dorna-robotics/blog/drawing/readme.md

# Tracing an Image

<p align="center">
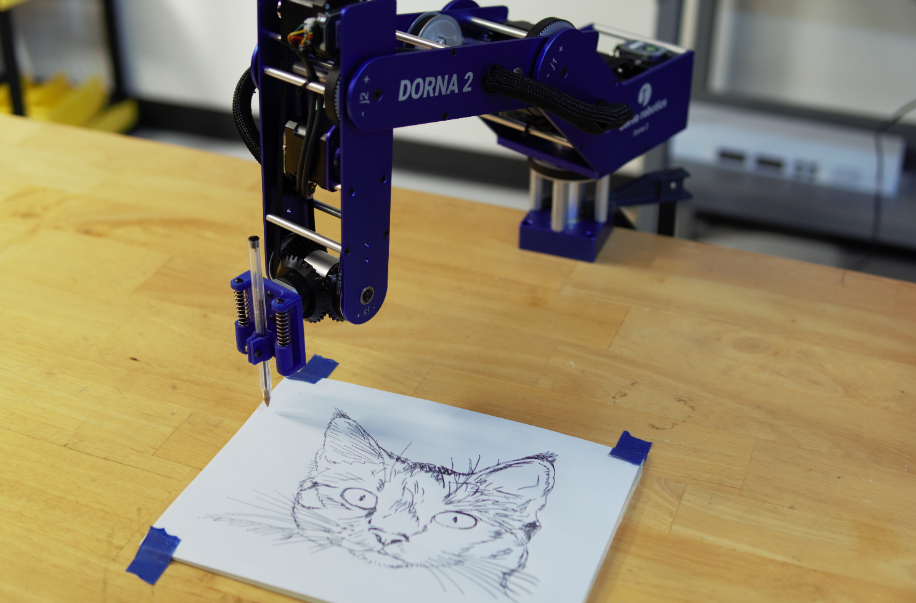
[picture p1: drawing/pictures/Thumbnail.png]

</p>

<p align="center">
<a href="https://youtu.be/N5IlFthJBqI">Link to Youtube video</a>
</p>

In this video we will go over the setup and the capabilities of the Dorna 2 robot for drawing an image. Dorna 2 robot can replicate SVG file to draw an image on a given surface. In this experiment we use Python programming language for converting the SVG file into robot commands.
 
You can find the original document here on our website:
https://dorna.ai/blog/dorna-drawing/
## Toolhead Installation
### Parts
We will need to attach the pen holder toolhead. We have the links to the materials below. You can use a 3D printer for two of the parts and you will need to order a few of the materials. 
|Items|Links|
|---|----|
|Two 3D printed parts|[link](https://github.com/dorna-robotics/dorna2_otto/tree/main/drawing/STL%20files)|
|9 x M3 10mm length and 1 x M3 bolt|[link](https://www.amazon.com/Sutemribor-320Pcs-Stainless-Button-Assortment/dp/B07CYNKLT2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)|
|2 x 35mm springs|[link](https://www.amazon.com/1mmx12mmx35mm-Stainless-Compression-Springs-Connector/dp/B08N6TKX5G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)|
|1 x pen(preferably a Bic pen)|[link](https://www.amazon.com/BIC-Round-Ballpoint-Medium-36-Count/dp/B00347A8NK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)|
|2 x 50mm Standoff Column Spacers with 5mm outer diameter|[link](https://www.amazon.com/uxcell-Aluminum-Standoff-Airplane-Quadcopter/dp/B07MJBHKDP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)|

<p align="center">
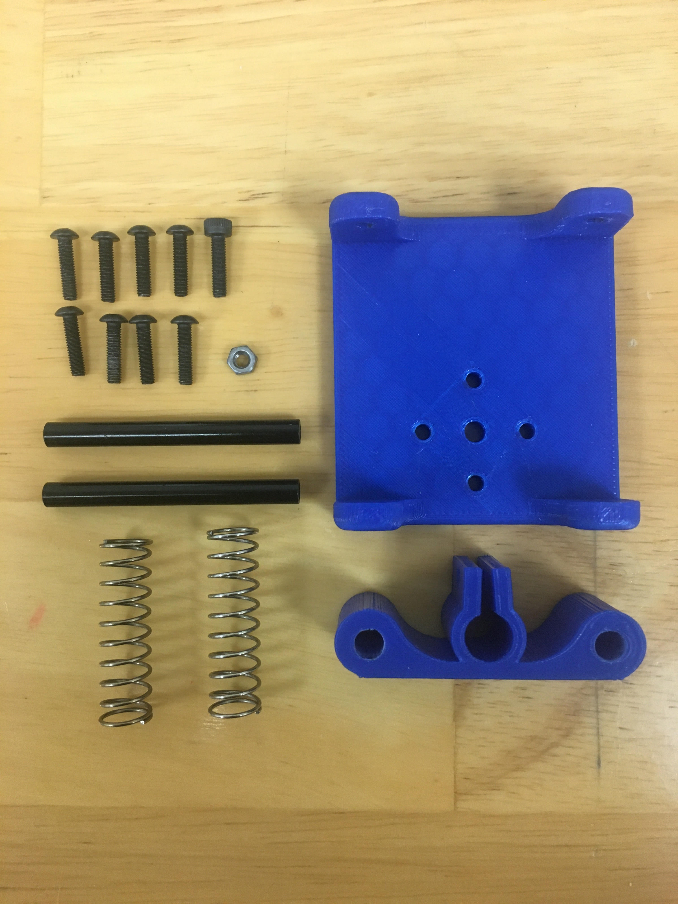
[picture p2: drawing/pictures/materiallist.jpg]

</p>

### Construction
Put the smaller 3D printed piece around the shafts and the springs attached as well. If the shaft doesn't slide along the small 3D printed piece it is recommended to sand paper the holes down. Make sure to have the small 3D printed piece oriented to hug the wall farthest from the mount holes on the larger 3D printed piece as shown below. Screw four M3 screws into the ends of the shafts to lock them in. Now attach the part to the Dorna 2 robot by using four M3 screws. Lastly put the pen through the large hole and screw on an M3 bolt and nut. If the pen is too small for the hole, an easy solution can be to wrap it in tape to create a bigger outer diameter for the pen.

<p align="center">
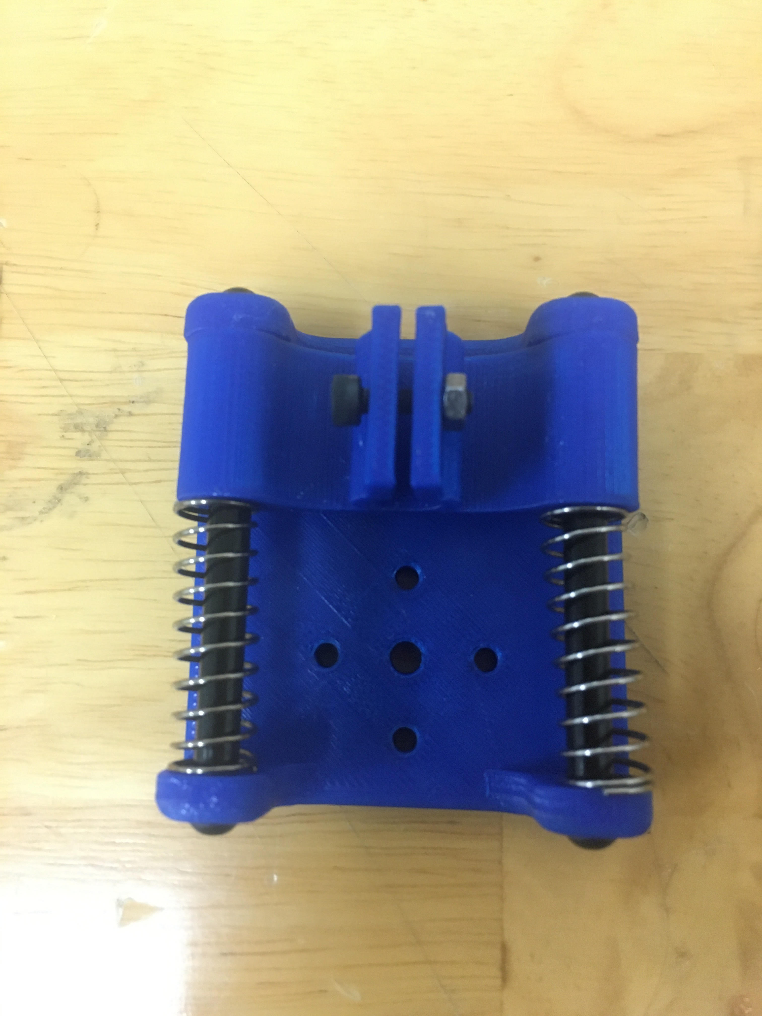
[picture p3: drawing/pictures/Topview.jpg]

</p>

## Code
A link to the code: https://github.com/dorna-robotics/blog/tree/main/drawing/code
### Image
Find an image in SVG format or convert a file to SVG format (use [InKscape](https://inkscape.org/) for that purpose). You can read into how the SVG format works thanks to [MDN](https://developer.mozilla.org/en-US/docs/Web/SVG/Tutorial/Paths).
### Actions Needed to Run
Here we use Python for programming the robot. You need to download [Python](https://www.python.org/downloads/) and [Dorna 2 Python API](https://doc.dorna.ai/docs/api/python/manual/) if you haven't already done so. The line below allows you to connect to your Dorna 2. Replace the `"robot_ip_address"` based on your robot ip address, [for more information on the API](https://doc.dorna.ai/docs/api/python/manual/).
```python
robot.connect("robot_ip_address", 443)
```
The line below takes the path to the SVG file and generates the commands associated to that SVG file.
```python
cmds, cmds_length = svg(10).gen('filename.svg', width, length, 0, 0, a, b, cp, scale, velocity, acceleration, jerk, corner)
```
When the program is run. It will ask you to turn off the motors. Be sure to hold the robot when turning off the motors because it will fall. Then a command will ask you to direct your robot to the left bottom corner of your paper. Make sure to have the toolhead attachment perpendicular to the surface. Not doing so will have the tool attachment going deeper into the surface than desired when drawing the image. For each point, set the pen so it is barely touching the surface. The command will then ask you to direct the robot to the top right of the paper. Lastly you will then direct the robot to a point along the line clockwise of the left bottom coordinate as shown below. A command asking to turn on the motors will come up. After doing so, the Dorna 2 robot will draw the image.

<p align="center">
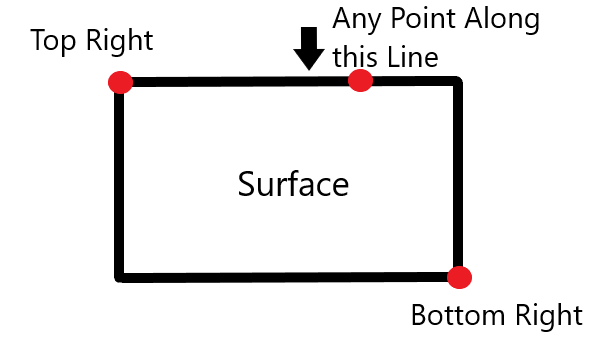
[picture p4: drawing/pictures/Setup.png]

</p>

This part of the code allows you to change the parameters for a faster drawing or a more precise drawing. Recommendations are given, but the numbers can be changed. The numbers will change the upper limits of the motion parameters.
```python
#the drawing will become slower and more precise by decreasing the numbers below
#the drawing will be drawn faster but less precise by increasing the numbers below
#changing the numbers will change the upper limits of the robots motion parameters
#recommended velocity = 50
velocity = 50
#recommended acceleration = 300
acceleration = 300
#recommended jerk = 3000
jerk = 3000
#recommended corner = 5
corner = 5
```
## Explanation of Code
### Main Function
We can take a look at the main function. This section is at the bottom of the code. The main function starts by connecting to the robot.
```python
if __name__ == '__main__':
    robot = dorna()
    print("connecting")
    robot.connect("ip address", 443)
    wait_id = 100
    print("done connecting")
    
```

Next the starting points are initialized by calling the `.startingpoints()` function. With the guidance of the user we can set the 3 points of the paper to understand the size of the paper and to understand the equation of the plane. This is used so if the surface isn't completely flat the program will modify the path to a new plane.

```python
#intialize the 3 points on the plane,Left Bottom-Point along line-Top Right
error, LB, M, TR = startingpoints(robot)
#check if there is an error from last function called
if(error == 1):
    print("need to restart")
    robot.close()
```
Next we call a function that allows us to find a 3rd corner of the paper. This helps us define the papers width and length and allows the program to have a upper limit for the surfaces width and length in 3D space.
```python
#calls function to find 3rd corner for new plane
TL = findcorner(LB, M, TR)
```
Now, we want to convert all points on an xy plane of the input SVG file to a xyz plane of the robot. This can be done by a linear formula of

[[x],[y],[z]]= T * [[x0],[y0]] + B

The T stands for transformation and can be solved using the 3 corners of the plane. T is a 3x2 matrix. B is a 3x1 matrix. B is the starting position's coordinates. 
Next we want to find the perpendicular vector from the plane. This will help to move the robot away from the paper when lifting the pen on a drawing.
```python
#perpendicular vector in unit vector form
cp = perpendicularvector(LB, M, TR)
```
Next is a function that creates the path. This is the bulk of the code. This function creates a xy path from the SVG path provided. The function will then transform the 2D path into a 3D path. The 3D path will then be translated into robot commands. 
```python
cmds, cmds_length = svg(10).gen(‘filename.svg', width, length, 0, 0, a, b, cp, scale, velocity, acceleration, jerk, corner)
```
The last few lines of the code takes the list of commands created from the the function above and sends it to the robot to perform. The robot will close the WebSocket connection and stop moving when the image is done. [For more information on robot commands](https://doc.dorna.ai/docs/cmd/intro/).
```python
 command_list=[]
 i=0
 stop=True
 while stop:
     for cmd in cmds:
         for c in cmd:
             command_list.append(robot.play(True, **c))
             if len(command_list)==cmds_length[i]:
                 last_continous_point = command_list.pop()
                 status = last_continous_point.complete()
                 command_list=[]
                 if(status == 2):
                     pass
                 else:
                     arg = {"cmd": "halt", "id":1000}
                     robot.play(True, **arg)
                     break
         i+=1
         if len(cmds_length)== i:
             stop=False
 print("done")
 robot.close()
```
