dorna-robotics/blog/camera/readme.md

# Additional Axes using a Camera Motor and Rail

<p align="center">
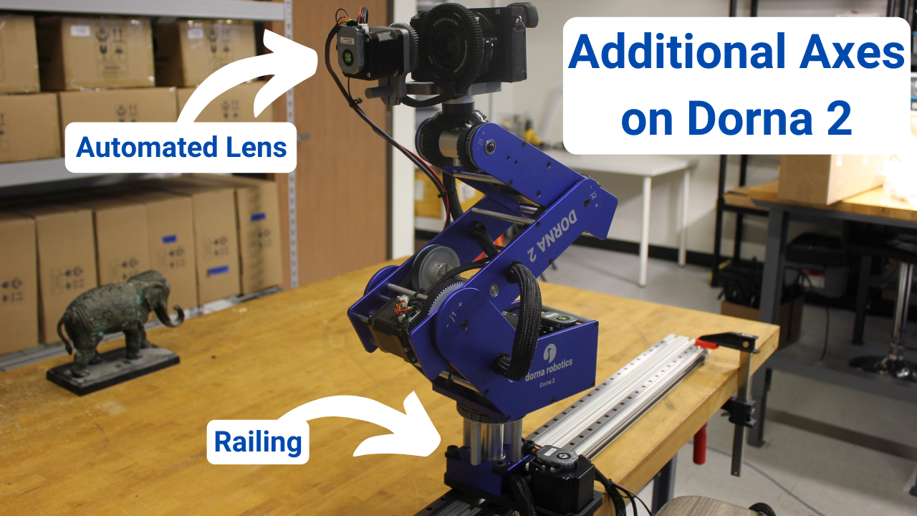
[picture p5: camera/pictures/thumbnail.png]

</p>

<p align="center">
<a href="https://www.youtube.com/watch?v=5VFXYQXdnUo">Link to Youtube video</a>
</p>
In this document we will showcase the Dorna 2's ability to add multiple degrees of freedom. We will go over the construction and the application of the camera attachment and railing.

## Camera Attachment

### Construction

Down below are all the materials you will need to run your Dorna 2 Robot with a camera attachment.

#### Building the Mount

|Items|Links|
|---|----|
|Three 3D printed parts| [link](https://github.com/dorna-robotics/blog/tree/main/camera/STL%20files) |
|8 x M3 bolts 8mm length, 2 x M3 Hex Nuts, 2 x M3 bolts 20mm length|[link](https://www.amazon.com/Sutemribor-320Pcs-Stainless-Button-Assortment/dp/B07CYNKLT2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)|
|1 x 1/4" bolt 3/8" length|[link](https://www.amazon.com/Socket-Stainless-Machine-Threads-RoyceMart/dp/B084NWFJZB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)|
|1 x Gear Strip|[link](https://www.amazon.com/Rubber-Flexible-DP500IIS-DP500III-Adjustable/dp/B078QYL2M8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)|
|1 x Driver and 1 x Stepper Motor and Wires||

<p align="center">
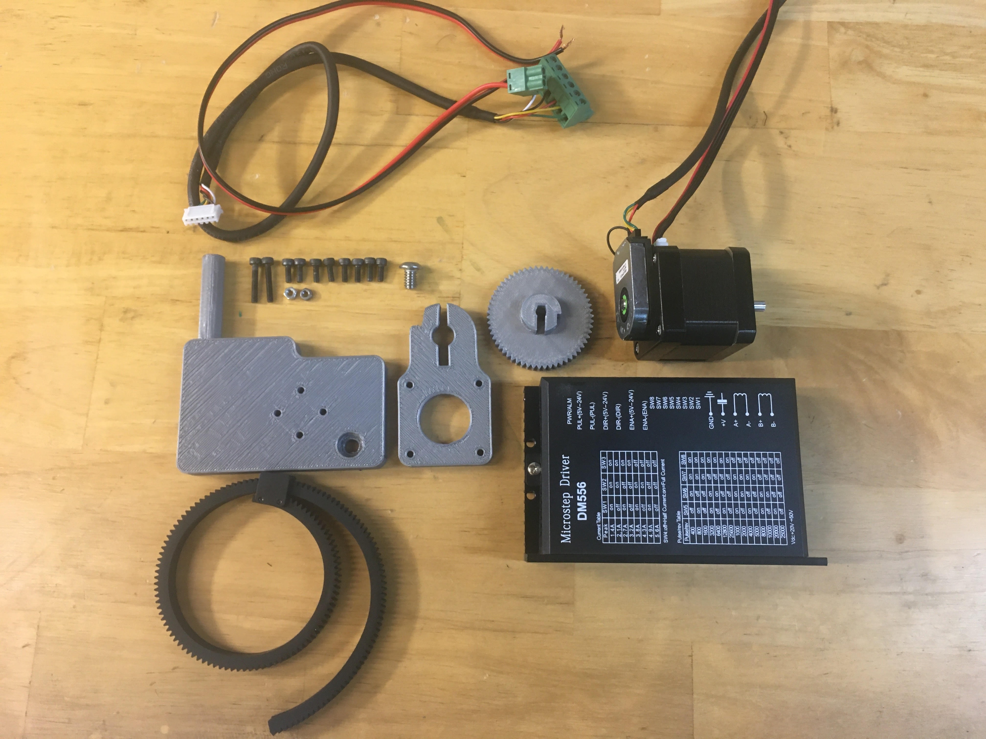
[picture p6: camera/pictures/construction.jpg]

</p>

Start by connecting the stepper motor to the motor-attachment(3D-printed part) by screwing the 4 x M3 bolts 8mm length into the four holes. Connect the gear(3D printed part) to the shaft of the stepper motor and tighten the gear to stop any slipping by screwing the M3 bolt 20mm length with a M3 hex nut. Home the robot before attaching the mount(3D printed part) to the robot. Then attach the mount to the robot with 4 x M3 bolts 8mm length. Attach the camera through the biggest hole on the camera mount using the 1/4" bolt 3/8" length. Orientate the camera so the lens is parallel to the shaft sticking out of the mount and facing towards that direction. Now attach the gearstrip to the camera lens so that the clip of the gearstrip is farthest from the shaft sticking out of the mount. Attach the motor attachment and mesh the gear to the gear strip. Tighten it with a M3 bolt 20mm length and M3 hex nut.

<p align="center">
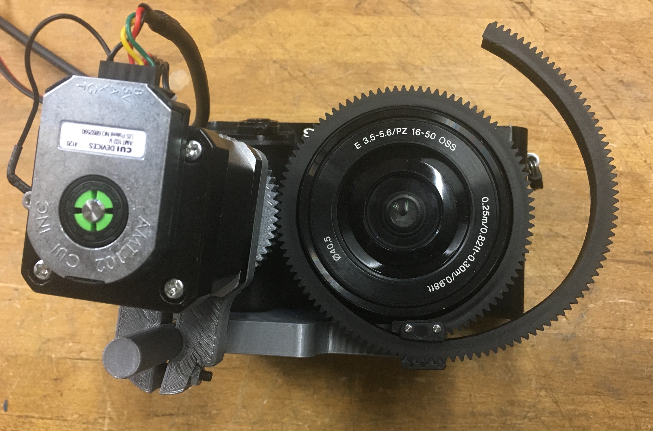
[picture p7: camera/pictures/cameramount.jpg]

</p>

#### Connecting to the Robot

Attach stepper motor to the stepper motor driver. Connect the encoder and stepper motor driver to the control box for the Dorna 2. The picture below shows inside the control box. The picture has a blue box showing the wiring for the encoder. The picture has a red box showing the wiring for the stepper motor driver. Currently a stepper motor is in the 6 axes position. An encoder would be plugged in directly across from stepper motor driver associated to it. Wire the enable, pulse, and direction into the driver. Be sure to choose the right wires. This can be easily obtained by putting the white plastic attachement into the control box and reading what color wire associates to what parameter(Enable, Pulse, and Direction). 

<p align="center">

</p>

### Application

Go to [lab.dorna.ai](http://lab.dorna.ai) and connect the robot and home it. Go to settings and then go to parameters and choose the correct number of axes. For each additional axes added be sure to count up from 5. In this case specifically choose 6 because we have 1 additional axes. Now you can input for j5 and find the values for the maximum and minimum extremes of j. Camera lens turn to different set angles so it is important to find the extremes. Set one side to 0 and spin the lens to find the maximum degree for j. Now you are able to teach your Dorna 2 to film using [lab.dorna.ai](https://lab.dorna.ai) or Python.

To learn more about the [Python API](https://doc.dorna.ai/docs/api/python/manual/) for those that want to use Python to control the Dorna 2. The additional axes can also be controlled in Python.
## Railing

### Construction

[Buy a Dorna Rail](https://dorna.ai/product/dorna-rail/)

[For the documentation on how to set up your Dorna rail](http://doc.dorna.ai/docs/accs/rail/)

### Application

Add one additional axes in [lab.dorna.ai](http://lab.dorna.ai) settings. For this specific case we now have 7 axes. Now you can operate both the railing and camera.
