dorna-robotics/blog/camera/STL files/gear.STL

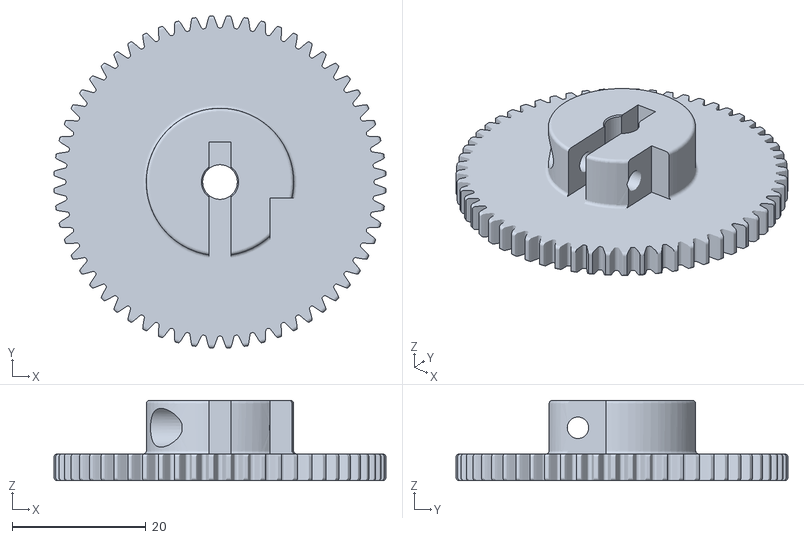
[picture p8: CAD file, 2021-07-02]
camera/STL files/gear.STL
49.6 x 49.6 x 12.0
