dorna-robotics/blog/drawing/STL files/PenHolderBase.STL

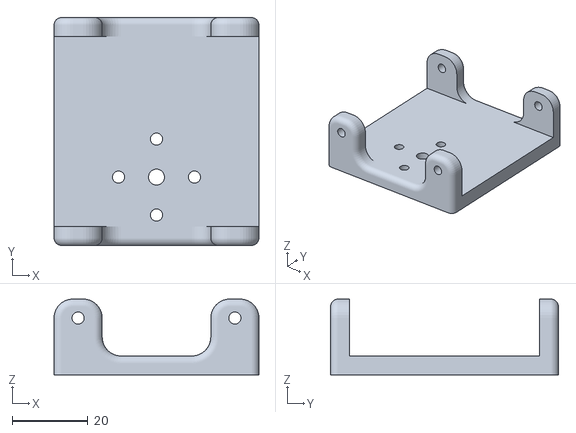
[picture p9: CAD file, 2021-06-16]
drawing/STL files/PenHolderBase.STL
54.0 x 60.0 x 20.0
