dorna-robotics/blog/camera/STL files/Mount.STL

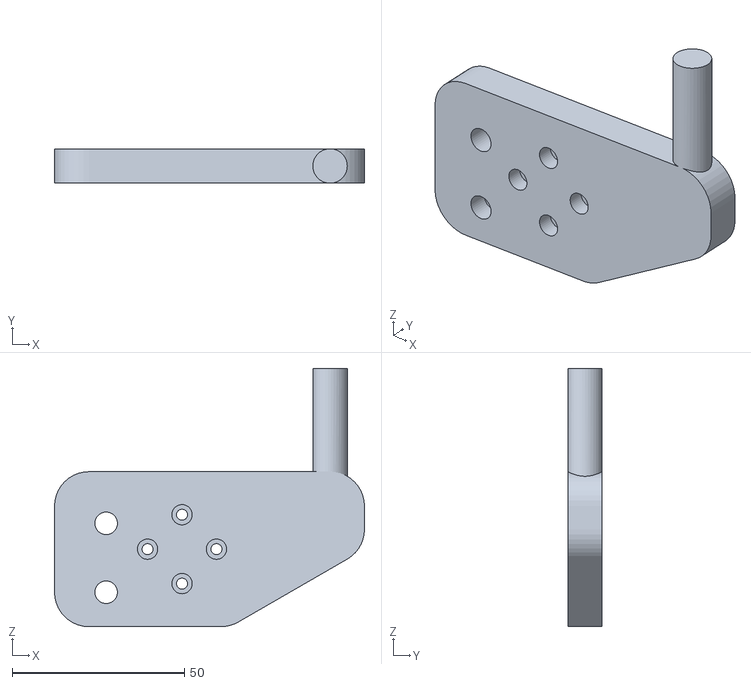
[picture p10: CAD file, 2021-07-02]
camera/STL files/Mount.STL
90.0 x 10.0 x 75.0
