dorna-robotics/blog/drawing/STL files/PenHolderAttachment.STL

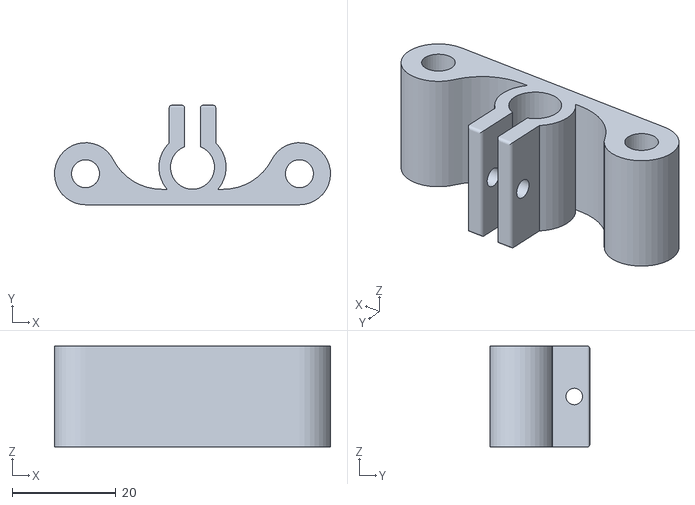
[picture p11: CAD file, 2021-06-16]
drawing/STL files/PenHolderAttachment.STL
53.3 x 19.2 x 19.5
