dorna-robotics/blog/camera/STL files/Motorattachment.STL

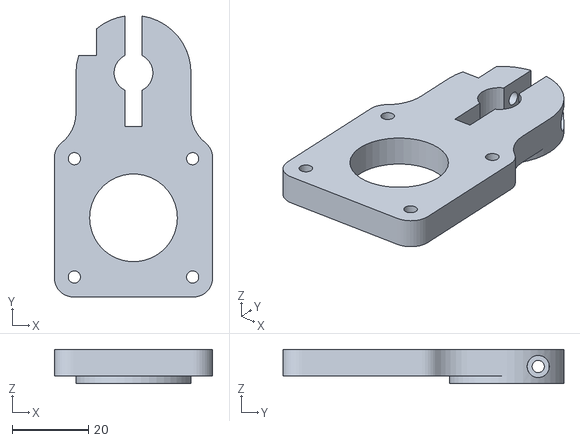
[picture p12: CAD file, 2021-07-02]
camera/STL files/Motorattachment.STL
41.5 x 73.7 x 9.00
